Li1433223Kai/stm32-smart-car/README.md

# STM32 智能循迹小车（两层闭环控制）

> **项目状态（2026-10）**：速度环 PI、显式状态机、FreeRTOS 运行时验证（调度器 / 时基 / 电机·编码器·灰度回归 / 多任务时间片轮转）均已实测通过，控制、串口、显示已拆成三个独立 RTOS 任务；位置环循迹参数在标准场地适配中（灰度模块为固定阈值，需白底黑线场地）。实车跑完整赛道待验证。

基于 STM32F103C8T6 独立开发的两轮差速闭环循迹小车。核心是**两层控制闭环**：

- **速度环（内环）**：编码器测速 + PI 控制，让左右轮精确达到目标转速
- **位置环（外环）**：8 路灰度循迹，根据黑线位置动态分配左右目标转速，实现差速转向

运行在 **FreeRTOS V9.0.0** 上：运行时验证（调度器 / 时基 / 外设回归 / 多任务轮转）通过后，控制逻辑先从裸机主循环搬进 `controlTask`（`vTaskDelayUntil` 锁 10ms 周期），随后串口打印与 OLED 显示也各自拆成独立任务。

通过该实践掌握：嵌入式软件分层架构（BSP/App）、PWM 调速、定时器编码器测速、PID 整定、显式状态机、FreeRTOS 任务划分、VOFA+ 上位机调参、实时性与踩坑排查。

## 实测验证（2026-08 ~ 2026-10）

- **速度环已实测调通**：闭环自动补偿两电机死区差异（左轮启动 PWM>600、右轮>400），消除纯 P 控制稳态静差
- **状态机已实测验证**：全黑/全白哨兵值优先判定避免电机失控；按键原地恢复运行
- **串口实时性修复验证**：修复 printf 阻塞拖垮 10ms 控制节拍导致速度环正反馈失控的问题
- **FreeRTOS 运行时验证通过**：调度器启动、时基递增、电机 / 编码器 / 灰度三项外设回归、多任务时间片轮转
- **控制任务重构已验收**：控制逻辑搬入 `controlTask`，功能回归通过；10ms 节拍锁定（100 拍 = 1000 tick，IDLE / RUN 态均无漂移）
- **三任务拆分已验收**：控制 / 串口 / 显示各一个任务；显示 200ms 一帧、实测单帧 133ms，同期控制节拍仍是 100 拍 = 1000 tick
- **OLED 已恢复显示**：驱动改走软件模拟 I2C（PB3/PB4），四行数据面板实测无残留
- **位置环循迹**：参数整定中，需白底黑线标准场地验证

## 硬件演进（实际搭建照片）

| 阶段 | 照片 |
|---|---|
| 8.18 基础版（能跑） | [`project/img/8.18基础可跑版.jpg`](project/img/8.18基础可跑版.jpg) |
| 8.21 加灰度循迹 | [`project/img/8.21带灰度版1.jpg`](project/img/8.21带灰度版1.jpg) · [`project/img/8.21带灰度版2.jpg`](project/img/8.21带灰度版2.jpg) |
| 8.25 加编码器测速 | [`project/img/8.25带编码器1.jpg`](project/img/8.25带编码器1.jpg) · [`project/img/8.25带编码器2.jpg`](project/img/8.25带编码器2.jpg) |
| 8.25 重装固件 | [`project/img/8.25重装后1.jpg`](project/img/8.25重装后1.jpg) · [`project/img/8.25重装后2.jpg`](project/img/8.25重装后2.jpg) |

## 系统架构

```
      位置环(外环)                 速度环(内环)
 灰度 pos ──→ 左右目标速度 ──→ PI ──→ PWM ──→ 电机 ──→ 编码器 ──→ 测速
      ▲                                                 │
      └──────────────────── 反馈 ──────────────────────────┘
```

## 软件分层

| 层 | 文件 | 职责 |
|---|---|---|
| BSP 驱动 | `bsp_motor.c` / `bsp_motor.h` | TB6612 电机 PWM + 方向安全时序 |
| BSP 驱动 | `bsp_gray.c` / `bsp_gray.h` | 8 路灰度读取、加权位置计算 |
| BSP 驱动 | `bsp_encoder.c` / `bsp_encoder.h` | 定时器编码器测速（RPM） |
| BSP 驱动 | `bsp_key.c` / `bsp_key.h` | 非阻塞去抖 + 沿检测按键 |
| BSP 驱动 | `bsp_oled.c` / `bsp_oled.h` | SSD1306 软件模拟 I2C 驱动 |
| BSP 驱动 | `bsp_uart.c` / `bsp_uart.h` | 打印队列 + `uartTask` |
| App 控制 | `app.c` / `app.h` | 位置环 + 速度环 PID、状态机、`controlTask`、`displayTask` |
| RTOS | `FreeRTOSConfig.h` / `freertos_hooks.c` | 内核裁剪与钩子函数 |
| 主程序 | `main.c` | 初始化 + 创建三个任务 + 启动调度器 |

## 技术要点

- 定时器编码器模式（TIM2/TIM4，4 倍频，1040 脉冲/圈，10ms 采样测速）
- 位置环 P + 速度环 PI 串级差速控制，积分 / 目标 / PWM 三重限幅防饱和
- IDLE / RUN / LOST / CROSS 显式状态机（10ms 调度）
- VOFA+ 上位机曲线调参（FireWater CSV）
- FreeRTOS V9.0.0（RVDS/ARM_CM3 port，heap_4）：控制 / 串口 / 显示三个任务，`vTaskDelayUntil` 锁周期，中断向量表已交内核接管
- 硬件细节：TB6612 换向安全时序、CD4051 切换 50us 稳定延时、编码器引脚上拉、OLED 走软件模拟 I2C 绕开已损坏的 PB8/PB9

## 硬件

- 主控：STM32F103C8T6
- 驱动：TB6612 双路（D153C）
- 电机：MG310 直流减速电机（霍尔编码器，13 线，减速比 20）
- 传感器：8 路数字灰度（CD4051 选通 + LM393 比较）
- 供电：12V 锂电池 → DCP3512（12V 电机 / 5V 主控与灰度，分路供电）

## 文档导航

| 文档 | 内容 |
|---|---|
| [project/docs/项目总结.md](project/docs/项目总结.md) | 项目总结 |
| [project/docs/调试记录.md](project/docs/调试记录.md) | 28 条踩坑排查 |
| [project/docs/开发日志.md](project/docs/开发日志.md) | 开发过程 |
| [project/docs/模块说明.md](project/docs/模块说明.md) | 各模块实现说明 |
| [project/docs/硬件连接.md](project/docs/硬件连接.md) | 引脚与供电 |
| [project/docs/项目参数.md](project/docs/项目参数.md) | 控制参数 |
| [project/docs/版本说明.md](project/docs/版本说明.md) | v1.0 ~ v2.2 演进 |

## 进展与规划

**已完成（2026-10）**

- **FreeRTOS V9.0.0 接入 + 运行时验证**：源码导入与向量表接管（09-23）→ 调度器启动与首任务（10-08）→ 时基和电机 / 编码器 / 灰度三项外设回归（10-09）→ 多任务时间片轮转（10-10）
- **控制任务重构**：裸机主循环三行控制逻辑搬入 `controlTask`，功能回归与 10ms 节拍验证均通过
- **串口与显示拆分**：串口改 snprintf + 队列 + `uartTask`，OLED 改 `displayTask` 每 200ms 一帧，控制任务不再被阻塞式打印和刷屏占用。架构现为**控制 / 串口 / 显示三个任务**
- 验证留档：[时基 dt 全为 1000](project/img/10.9时基验证_dt全为1000.png) · [编码器速度符号与正反转](project/img/10.9编码器验证_左右速度符号与正反转.png) · [控制任务功能回归](project/img/10.10控制任务重构_功能回归ST1到ST3.png) · [节拍 100 拍 1000 tick](project/img/10.10控制任务节拍验证_100拍1000tick.png)

**下一步**

- 实车跑完整赛道（当前 RTOS 架构下只做过架空功能回归）
- 标准场地循迹参数适配、量化性能数据（稳态误差 / 超调 / 线速度）

**更远**

- 串口升级为 **DMA + 空闲中断 + 环形缓冲**，支持不定长协议
- ADC 电池电压监测、SPI Flash（W25Q64）驱动
