Li1433223Kai/stm32-smart-car/project/docs/项目总结.md

# STM32 智能循迹小车 —— 项目总结

> 更新：2026-10-16（FreeRTOS 源码接入 2026-09-23，首次运行验证 2026-10-08，时基与三项功能回归验证 2026-10-09，多任务轮转验证 2026-10-10，控制逻辑搬入 controlTask 2026-10-10，串口与显示拆为独立任务 2026-10-15~10-16）
> 定位：独立开发，作为嵌入式软件方向的能力证明
> 代码：`../code/smart/`（Keil MDK 工程，Target: f103）

## 一、项目概述

基于 STM32F103C8T6（Cortex-M3）独立搭建并开发的两轮差速循迹小车，
实现「位置环 P + 速度环 PI」串级双闭环控制。目标不只是拼模块跑起来，
而是用分层架构、显式状态机、实时性意识和闭环控制，把一辆车从零**调通**。

## 二、项目目标与范围

- **主线**：从零搭建一辆「速度环调通、能循迹」的小车，覆盖 驱动 → 控制 → 实时性 → 调试 全链路
- **工程化**：BSP/App 分层、模块化驱动、规范提交、完整技术文档
- **实时性**：10ms 控制节拍稳定，不被 IO 阻塞破坏
- **边界**：不追求花哨功能，把单个方向做到深度可讲

## 三、系统与硬件

| 模块 | 说明 |
|---|---|
| 主控 | STM32F103C8T6 |
| 电机驱动 | TB6612 双路（D153C），PWM 0~7200 |
| 电机 | MG310 直流减速电机（霍尔编码器 13 线，减速比 20） |
| 测速 | TIM2/TIM4 定时器编码器模式，4 倍频，1040 脉冲/圈，10ms 采样 |
| 循迹 | 8 路数字灰度（CD4051 选通 + LM393 比较），加权位置 -7000~+7000 |
| 显示 | SSD1306 0.96" OLED，软件模拟 I2C，SCL=PB3 / SDA=PB4 |
| 按键 | PA8 上拉，非阻塞去抖 + 沿检测 |
| 供电 | 12V 锂电 → DCP3512（12V 电机 / 5V 主控与灰度，分路供电） |

完整引脚见 `硬件连接.md`。

## 四、软件架构

按 BSP（驱动层）/ App（应用层）两层组织，`main.c` 只做初始化、创建任务、启动调度器：

```
BSP 驱动层：bsp_motor / bsp_gray / bsp_encoder / bsp_key / bsp_oled / bsp_uart
App 应用层：app.c（位置环 + 速度环 + 状态机 + controlTask + displayTask）
main.c    ：初始化 + 创建三个任务 + 启动调度器

三个任务的分工：
  controlTask   优先级 2   10ms 一拍    编码器更新 / 状态机 / 速度环
  uartTask      优先级 1   阻塞等队列   取一帧 printf 一帧
  displayTask   优先级 1   200ms 一拍   刷 OLED 数据面板
```

自写代码约 1000+ 行（不含 HAL 驱动库），分 16 个源文件。

## 五、核心实现

### 1. 串级双闭环控制
- **位置环（外环）**：`Gray_GetPosition()` 返回黑线位置 pos（-7000~+7000，哨兵值 9999/-9999），
  P 控制算出左右轮目标转速差，实现差速转向
- **速度环（内环）**：编码器 10ms 采样 → RPM，PI 控制达到目标转速
- **三重视限幅防饱和**：积分限幅 2000、目标限幅（40~200）、PWM 限幅 7200

### 2. 显式状态机（IDLE / RUN / LOST / CROSS，10ms 调度）
- IDLE：上电默认停车，200ms 屏蔽按键防上电误触，按 PA8 进 RUN
- RUN：正常压线跑位置环；全白 → LOST，全黑 → CROSS
- LOST / CROSS：进入当拍 `App_Stop()` 清目标积分 + `Motor_BrakeAll()` 短接刹车，并用 `s_brake` 标志保持刹车态（速度环短路不再输出，避免覆盖）；按 PA8 原地恢复，无需断电重启
- 关键：全白/全黑**先判 ±9999 哨兵值再进位置环**，避免异常值被当作极大偏差驱动电机疯转

### 3. 实时性处理
- **修复 printf 阻塞**：`fputc` 原用 `HAL_MAX_DELAY` 无限等待，串口变慢时把 10ms 节拍拖到
  数百 ms，速度环采样间隔不稳形成正反馈、电机失控反转；改为 50ms 超时 + 打印限频 500ms
- **把耗时 IO 挪出控制任务**：控制任务里的 printf 换成 snprintf + 队列（`Uart_Send` 入队即返回，满则丢帧），
  刷屏从控制任务挪进 `displayTask`，控制任务的当拍时间不再被这两样占着

### 4. 硬件相关细节
- TB6612 换向遵循「关 PWM → 改方向 → 恢复 PWM」，避免绕组电感电流突变产生数倍堵转电流尖峰
- CD4051 通道切换后保留 50us 等 LM393 比较器稳定（缺失时实测通道 1/5 互换误读）
- 编码器引脚改上拉输入，抑制信号线虚接时计数乱跳
- OLED 改走软件模拟 I2C（PB3/PB4）：硬件 I2C1 在这块板上没有落点——默认的 PB6/PB7 被右编码器占了，重映射的 PB8/PB9 已被旧屏那次的 12V 打穿

## 六、关键参数

| 项 | 值 |
|---|---|
| 位置环 | KP=1.5，BASE_SPEED=120 RPM，TARGET_MIN=40，MAX_STEER=80 |
| 速度环 | PID_KP=15，PID_KI=1，INTEGRAL_MAX=2000 |
| PWM | 0~7200 |
| 测速 | 1040 脉冲/圈，10ms 采样 |

## 七、实测验证结果（截至 2026-10）

| 项 | 状态 |
|---|---|
| 速度环闭环 | 调通：自动补偿左右轮死区差异，消除稳态静差 |
| 状态机 | 验证：全黑/全白不失控（8.31 桌面）、LOST 触发与 PA8 原地恢复（9.12 实车） |
| 快速刹车（s_brake 保持） | 实车验证（9.12，甩-松手判据：快甩松手立即停转） |
| Δt 实测间隔测速 | 编译通过，待实车回归对照 |
| 串口实时性 | 修复验证：10ms 节拍恢复，打印不再拖慢 |
| 位置环循迹 | 参数整定中，需白底黑线标准场地（灰度为固定阈值） |
| OLED | 已恢复显示：驱动改走软件模拟 I2C（PB3/PB4），四行数据面板实测无残留 |
| **量化性能数据** | **待测**：稳态误差 / 阶跃超调 / 调节时间 / 循迹线速度 / 直线偏差 |
| **FreeRTOS 工程编译** | 0 Error / 8 Warning（2026-10-08；Code=11908、ZI-data=11840，堆已落地） |
| **FreeRTOS 源码接入（导入 / 分组重组 / Config / 向量表接管）** | 完成（2026-09-23）——**仅并入源码、搭好工程环境，业务逻辑未改** |
| **FreeRTOS 中断向量表接管** | map 文件验证：SVC/PendSV/SysTick 符号落在 port.o（2026-09-23） |
| **FreeRTOS 调度器启动 + 首任务运行** | 实测通过（2026-10-08）：PC13 每 500ms 闪烁 + 串口输出 `control test start`；堆随任务创建落地（ZI 1596→11840） |
| **FreeRTOS 时基验证** | 实测通过（2026-10-09）：连测 18 次 `vTaskDelay(1000)` 的 `HAL_GetTick()` 差值全部为 1000，tick hook 链路导通、无丢拍、无漂移 |
| **FreeRTOS 外设功能回归（电机 / 编码器 / 灰度）** | 实测通过（2026-10-09）：电机正反转+刹车节奏正常；编码器正转读数为正、反转读数为负、左右符号一致、刹车归零（截图 `project/img/10.9编码器验证_左右速度符号与正反转.png`）；灰度 pos 稳定、方向与哨兵值正常。顺带销案"右编码器 A/B 是否也反——未验证"→ 实测未反 |
| **FreeRTOS 多任务轮转** | 实测通过（2026-10-10）：建两个同优先级任务（task1/task2，优先级均 2）各自刷串口，1 与 2 成块交替出现，时间片（1ms）轮转生效 |
| **FreeRTOS 串口早期输出异常（fputc）** | 已修（2026-10-10）：原 fputc 用 HAL_UART_Transmit(...,50)，其超时靠 HAL_GetTick，而 suspend 窗口内 uwTick 冻结导致超时失效、早期丢字；改为不依赖 tick 的寄存器版 |
| **FreeRTOS 运行时验证（四项）** | 全部通过：调度器能跑 / 时基 / 三项外设回归 / 多任务轮转（2026-10-08~10-10） |
| **控制任务重构** | 验收通过（2026-10-10）：裸机主循环三行搬入 `controlTask`，功能回归通过；100 拍 = 1000 tick |
| **串口 / 显示拆分为独立任务** | 验收通过（2026-10-16）：串口走队列 + `uartTask`，显示走 `displayTask`（200ms 一帧、实测单帧 133ms）；同期控制节拍仍是 100 拍 = 1000 tick |
| **OLED 字模** | 换 VGA 8x16 点阵，字形只占第 2~11 行，四行文本之间有了行距 |
| **架构是否已切换为多任务 RTOS** | 已切换——控制 / 串口 / 显示三个任务（串口 10-15、显示 10-16 完成后定稿）；中断与调度由 FreeRTOS 接管 |

> **量化数据待补**：目前有「参数」暂无「性能指标」。计划标准场地循迹调通后，
> 用 VOFA+ 抓波形，测出稳态误差、超调量、调节时间与循迹线速度，回填本节。

## 八、踩坑总结（28 项，详见 调试记录.md）

按类别归纳：

- **接线/接触类（最常见：#4 #7 #10 #11）**：杜邦线内部断、AD0/AD2 接反、编码器 A/B 接反、面包板虚接
  → 学会用「交换测试 / 交叉验证」定位
- **电源类（#5）**：供电反接烧驱动板 → 先量电源轨短路再上电
- **流程类（#19 #20）**：printf 阻塞拖垮控制节拍、改完代码忘了烧录——问题往往不在想查的那一层 → 养成"验收先确认烧录版本、复现最先做"的习惯
- **程序/工程（#2 #3 #8 #15）**：Keil 插件终端、缺 stdio.h、main 少 `}`、VSCode 工程打开方式
- **硬件个体差异（#6）**：电机死区不同 → 闭环 PID 自动补偿
- **控制参数（#12 #13）**：低速量化误差放大 → Kp 50→15；纯 P 静差 → 加 Ki
- **实时性（#19）**：printf 阻塞破坏节拍 → 超时 + 限频；后来进一步拆成独立任务
- **外设时序（#7）**：CD4051 切换 50us 稳定延时
- **显示（#28）**：新屏不亮，一步步剥下来是 PB8/PB9 的引脚保护结构被旧屏 12V 打穿（推挽顶高只有 0.6V、二极管档双向导通），OLED 因此改走软件模拟 I2C 到 PB3/PB4
- **RTOS 时序/环境类（#23~#27）**：**#23** HAL 与 FreeRTOS 抢用 SysTick —— HAL 在 `HAL_Init` 里就提前使能了 SysTick，而向量表已交给 FreeRTOS、调度器却还没启动，第一次 tick 进来即解引用未初始化的延时链表 → HardFault（LED 常亮）。编译、链接、向量、配置全对，**静态检查抓不到**，只能靠"谁在什么时候第一次碰内核状态"的时序链推 → 修复要"关两次"（`HAL_Init` 后 + `SystemClock_Config` 后各 `HAL_SuspendTick()`）；**#24** 修完后验证时基未因 tick 链路多绕两道而失准（连测 18 次 `dt` 全为 1000）；**#25** 三项外设回归（电机/编码器/灰度）—— 采样型任务（编码器、灰度）必须用 `vTaskDelayUntil` 锁周期而非 `vTaskDelay`，且打印必须降频（一行约 10 字符约 10ms，不降频会吃满 10ms 采样周期）；**#26** 多任务轮转验收（两个同优先级任务各自刷串口、1 与 2 成块交替），排查过程中还发现"注释掉两个任务后早期日志就正常"——早期 printf 其实一直有发出去，只是被无间隔刷屏抢了接收时序；**#27** 动了 HAL 时基（`HAL_SuspendTick`）之后，所有靠 `HAL_GetTick()` 做超时的 HAL 函数都会失效，范围不止 `HAL_Delay` 型延时，UART/I2C 收发与各 `HAL_xxx_Init` 全在内，表现为静默丢字/乱码，不报错也不 HardFault —— 修法是把 `fputc` 改成不依赖 tick 的纯寄存器版

## 九、技术收获

1. 分层架构与模块化：单一职责、接口封装（BSP/App）
2. 串级控制整定的真实手感：内环带宽、量化误差、积分限幅
3. 显式状态机的边界处理：哨兵值、进入沿检测
4. 嵌入式实时性意识：阻塞 IO 对控制节拍的破坏与规避
5. 硬件调试方法论：交叉验证、分级上电、先量短路
6. 版本管理与文档习惯：Conventional Commits、6+ 份文档、记录踩坑

## 十、不足与后续规划

| 项 | 现状 | 规划 |
|---|---|---|
| 串口 | 队列 + `uartTask` | **DMA + 空闲中断 + 环形缓冲**（不定长协议） |
| 控制节拍 | `vTaskDelayUntil` 锁 10ms | **独立定时器节拍**（不依赖 SysTick） |
| 外设 | 已有 7 个驱动 | **ADC 电池监测、SPI Flash(W25Q64)** |
| 架构 | 控制 / 串口 / 显示三个任务 | 实车跑通后按需再拆，补齐任务间通信 |
| 循迹验证 | 待标准场地 | 白底黑线场地完整跑通 |
| 性能数据 | 待测 | 稳态误差 / 超调 / 线速度等量化指标 |
| 硬件 | 模块 + 杜邦线 | 自研扩展板 PCB（嘉立创 EDA） |

## 十一、一句话总结

一辆把「分层架构、串级双闭环、显式状态机、实时性、硬件调试」全部落到真实硬件上的
STM32 循迹小车；**速度环、状态机与快速刹车验证通过，FreeRTOS 接入后已把控制 / 串口 / 显示拆成三个任务并实测节拍不受影响（控制 100 拍 = 1000 tick），位置环循迹与性能数据在标准场地继续完善**。
