Li1433223Kai/stm32-smart-car/project/img/8.21带灰度版1.jpg

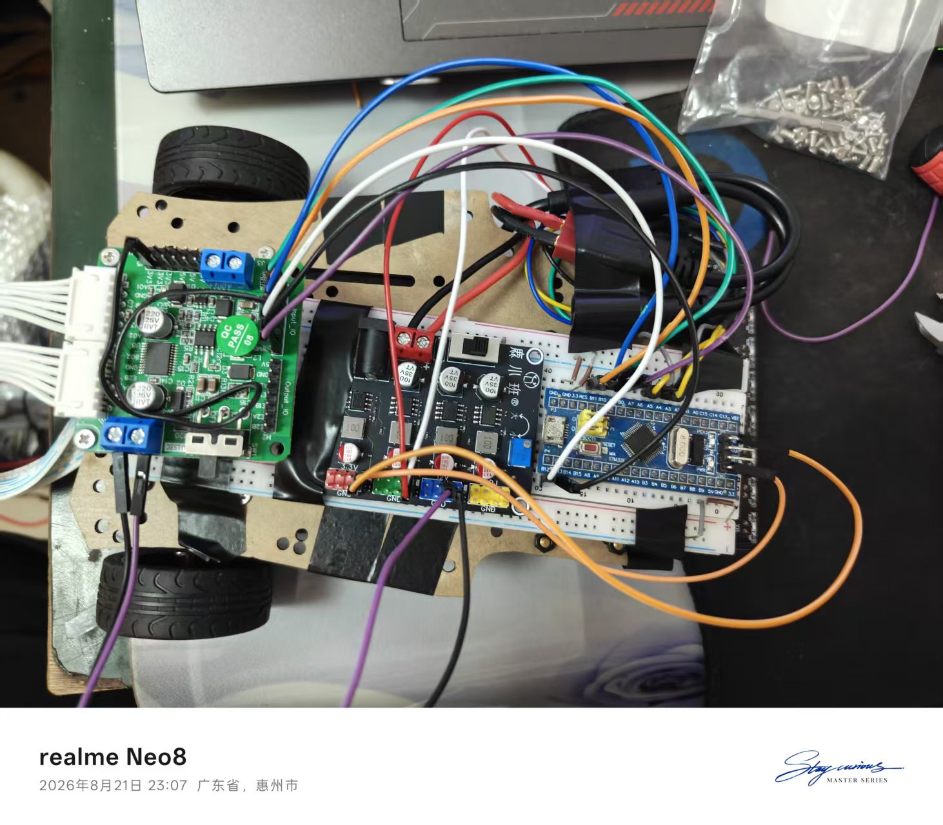
project/img/8.21带灰度版1.jpg
