Li1433223Kai/stm32-smart-car/project/img/8.25重装后1.jpg

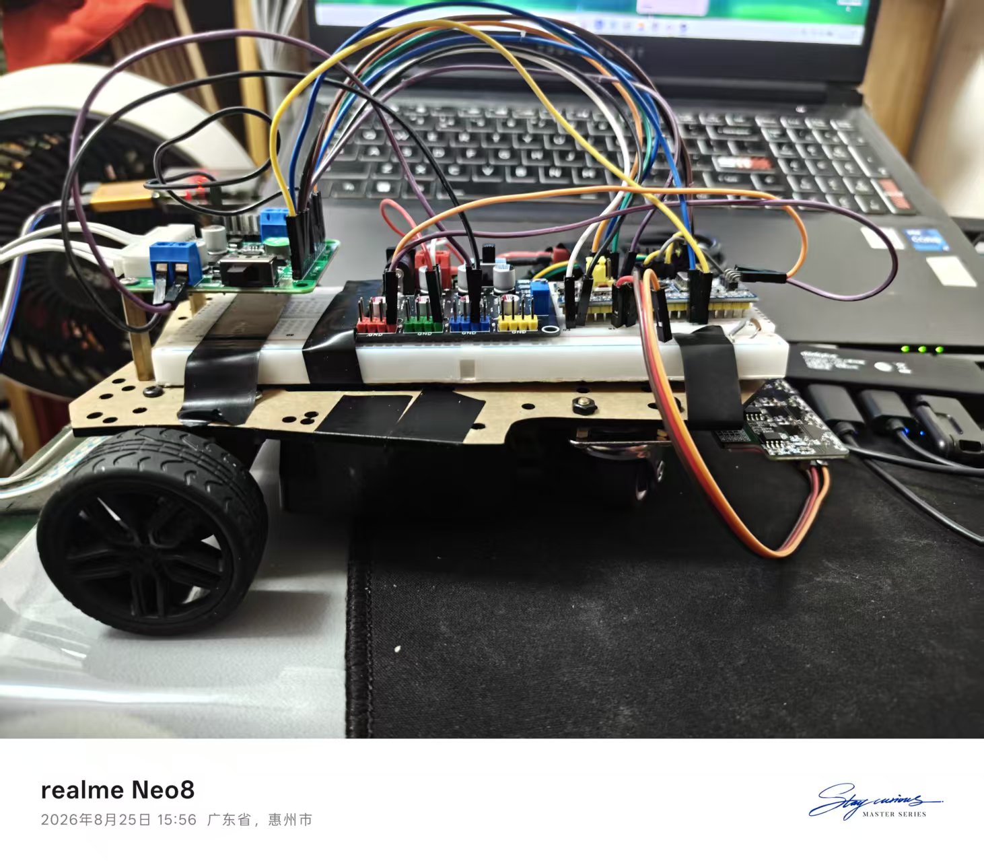
project/img/8.25重装后1.jpg
