Li1433223Kai/stm32-smart-car/project/code/smart/Core/Src/main.c

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
/* Includes ------------------------------------------------------------------*/
#include "main.h"
#include "tim.h"
#include "usart.h"
#include "gpio.h"

/* USER CODE BEGIN Includes */
#include <stdio.h>
#include "bsp_motor.h"
#include "bsp_gray.h"
#include "app.h"
#include "bsp_encoder.h"
#include "bsp_oled.h"
#include "bsp_key.h"
#include "FreeRTOS.h"
#include "task.h"
#include "bsp_uart.h"
/* USER CODE END Includes */


void SystemClock_Config(void);
/**
  * @brief  The application entry point.
  * @retval int
  */
int main(void)
{

  /* MCU Configuration--------------------------------------------------------*/

  /* Reset of all peripherals, Initializes the Flash interface and the Systick. */
  HAL_Init();
  

  /* USER CODE BEGIN Init */
  HAL_SuspendTick();
  /* USER CODE END Init */

  /* Configure the system clock */
  SystemClock_Config();
  HAL_SuspendTick(); //成对存在


  /* Initialize all configured peripherals */
  MX_GPIO_Init();
  MX_USART1_UART_Init();
  MX_TIM3_Init();
  MX_TIM2_Init();
  MX_TIM4_Init();
  /* I2C1 外设已弃用: OLED 改走 PB3/PB4 软件 I2C, 见 BSP/bsp_oled.c */
  /* USER CODE BEGIN 2 */
  Motor_Init();
  Motor_StopAll();     /* 开始循迹前电机先停 */
  Gray_Init();
  App_Init();
  Encoder_Init();
  Key_Init();
  Uart_Init();

  /* 控制任务栈 256 word(1KB): 调用链里有 snprintf, 128 word(512B) 余量偏紧 */
  if(xTaskCreate(controlTask,"controlTask",256,NULL,2,NULL) != pdPASS)
  {
	printf("controlTask fail\r\n" );
	Error_Handler();		  
  }
  
  if(xTaskCreate(uartTask,"uartTask",192,NULL,1,NULL) != pdPASS)
  {
	printf("uart fail\r\n" );
	Error_Handler();		  
  }
  
  if(xTaskCreate(displayTask,"displayTask",192,NULL,1,NULL) != pdPASS)
  {
	printf("display fail\r\n" );
	Error_Handler();		  
  }
  vTaskStartScheduler();
  /* USER CODE END 2 */

  /* Infinite loop */
  
  /* USER CODE BEGIN WHILE */
  while (1)
  {
    /* USER CODE END WHILE */

    /* USER CODE BEGIN 3 */

  }
  /* USER CODE END 3 */
}
  

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
/* USER CODE BEGIN 4 */
int fputc(int ch, FILE *f)
{
    /* 直接写寄存器, 纯空转等 TXE, 不依赖 HAL_GetTick 超时 */
    uint32_t guard = 0;
    while (!(USART1->SR & USART_SR_TXE) && ++guard < 100000)
    {
    }
    USART1->DR = (uint8_t)ch;
    return ch;
}
/* USER CODE END 4 */
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
