Li1433223Kai/stm32-smart-car/project/code/smart/Core/Inc/main.h

#define LED_Pin GPIO_PIN_13
#define LED_GPIO_Port GPIOC
#define AIN1_Pin GPIO_PIN_10
#define AIN1_GPIO_Port GPIOB
#define AIN2_Pin GPIO_PIN_11
#define AIN2_GPIO_Port GPIOB
#define BIN1_Pin GPIO_PIN_12
#define BIN1_GPIO_Port GPIOB
#define BIN2_Pin GPIO_PIN_13
#define BIN2_GPIO_Port GPIOB
#define GRAY_AD0_Pin GPIO_PIN_2
#define GRAY_AD0_GPIO_Port GPIOA
#define GRAY_AD1_Pin GPIO_PIN_3
#define GRAY_AD1_GPIO_Port GPIOA
#define GRAY_AD2_Pin GPIO_PIN_4
#define GRAY_AD2_GPIO_Port GPIOA
#define GRAY_OUT_Pin GPIO_PIN_5
#define GRAY_OUT_GPIO_Port GPIOA
