Li1433223Kai/stm32-smart-car/(commit log)

2026-08-20 feat: 智能循迹车项目初始提交
    - 基于STM32F103C8T6 + HAL库 + Keil MDK工程框架
    - 实现TB6612双路电机驱动(D153C), TIM3 CH3/CH4输出10kHz PWM
    - 电机方向控制: PB10/PB11(左), PB12/PB13(右)
    - 串口USART1调试输出(PA9/PA10), printf重定向
    - LED闪烁 + 电机正反转2秒循环测试程序
    - BSP层封装: Motor_Init/Motor_SetSpeed/Motor_Stop/Motor_Brake/Motor_StopAll
    - MotorID枚举适配D153C双路板: MOTOR_A(左轮)/MOTOR_B(右轮)
    - 修复Motor_Brake中PWM=0导致高阻态而非真刹车的bug
    - 添加项目文档: 硬件连接、开发日志、调试记录、模块说明等
    - 包含STM32F1xx HAL库和标准外设库旧模板
2026-08-21 feat: 适配D153C双路TB6612驱动板，修复方向切换时序
    - 引脚标签重命名: BIN1/BIN2→AIN1/AIN2(左轮), CIN1/CIN2→BIN1/BIN2(右轮)
    - 更新main.h/gpio.c/bsp_motor.c/bsp_motor.h/f103.ioc中所有引用
    - 修复Motor_SetSpeed方向切换顺序: 先关PWM(CCR=0)→切方向引脚→开PWM
    - 修复Motor_Brake顺序: 先设IN1=IN2=1→再设PWM满占空比
    - Motor_Init安全启动: 方向引脚先清零→CCR=0→启动PWM
    - 更新tim.c PWM通道注释: PB0=PWMB(右), PB1=PWMA(左)
2026-10-13 docs: 添加8.21调试记录(电机死区/驱动板适配/方向切换时序)
    补上 8.21 的调试记录，三条：
    - 低 PWM 下左轮不动、右轮正常，定到电机个体死区差异（左轮 >600 才转、右轮 >400）
    - 换 D153C 驱动板后转向乱，是代码里的引脚标签没跟着改成 AIN1/AIN2、BIN1/BIN2
    - 方向切换时电机抖一下，是切换顺序不安全，改成先关 PWM 再切方向
    main.c 的测试 PWM 从 3000 降到 1500，先避开死区。
2026-10-13 feat: 添加八路数字灰度传感器驱动(bsp_gray)
    - 引脚分配: PA2=AD0, PA3=AD1, PA4=AD2(通道选择), PA5=OUT(数字输入)
    - 在f103.ioc/main.h/gpio.c中配置GPIO
    - 实现Gray_Init/Gray_ReadChannel/Gray_ReadAll/Gray_GetPosition
    - 加权位置算法: -7000~+7000表示黑线偏离中心位置
    - 支持丢线(9999)和全黑(-9999)状态检测
    - main.c测试程序: 串口每100ms打印8路灰度值和位置
2026-10-13 fix: 修正灰度传感器驱动(根据官方手册)
    - 供电电压: 5V(不是3.3V!)
    - 输出电平: 黑线=1(灯亮=高电平), 白线=0(灯灭=低电平), 与官方例程一致
    - 通道切换延时: 从NOP改为50us延时(匹配官方例程delay_us(50))
    - 添加Gray_Delay_us微秒延时函数
    - 更新注释: 通道CH1~CH8对应数组索引0~7, 最佳高度18mm
2026-10-13 fix: 修正main.c灰度测试注释(1=黑0=白)
    main.c 里灰度输出的注释写反了。按实际约定改回 1=黑（灯亮）、0=白（灯灭），
    跟 bsp_gray 内部判读对齐，免得之后照注释把方向调反。
2026-10-13 fix: 恢复灰度通道切换50us延时，修复通道1/5互换
    灰度测试发现通道1与5数据互换，根因是读取OUT前缺少50us稳定延时(LM393比较器未稳定即采样)；另修正AD0/AD2接线。灰度8路现已全部验证正常。
2026-10-13 docs: 补全8.23灰度通道错位调试记录(原因与解决方法)
    8.23 灰度错位那条当时只记了现象（挡 1 号灯亮 5 号、打印成 51372648），
    这次补上原因和解法：AD0/AD2 接反，加上通道切换后没留稳定延时，两个问题
    叠一起才出的乱码。
2026-10-13 chore: 删除旧标准库模板工程(2-1stm32工程模板)
    删掉已经不用的标准库模板工程（2-1stm32工程模板，带一整份 StdPeriph 库，
    几百个文件），工程只留 HAL 这套。
2026-10-13 docs: 添加代码逻辑目录文档(开发日志/motor逻辑等)
    搭 docs 的架子：新增 motor.md 写电机驱动逻辑，模块说明、硬件连接、项目参数、
    项目总结先建空文件占位，开发日志补个开头。内容后面逐步填。
2026-10-13 feat: 添加循迹控制模块框架(app.c/app.h)
    建应用层骨架。app.c/app.h 放循迹逻辑，由 main 主循环按固定节拍调用，
    里面只调 bsp_motor 和 bsp_gray 的接口，不碰寄存器。
    这一版只做"纯直行"：读一下 pos 但先不用，两轮给同一个 base 速度。为的是
    确认两个电机都能正转、base 选得住（得高于左轮死区）。差速留到下一步。
2026-10-13 feat: 将app.c加入Keil工程，并忽略Keil本地配置uvoptx
    把 app.c 加进 Keil 工程的 BSP 分组，编译时能带上。同时把 f103.uvoptx
    从版本控制里去掉：这是 Keil 的本地窗口/断点配置，只对本机有效，入库没意义。
2026-10-13 feat: 接入app循迹主循环，更新灰度引脚配置并记录8.24调试
    main 主循环从原来的"只打印灰度"改成调 App_Follow()：20ms 跑一拍循迹，
    另外每 200ms 打一次 pos 方便看。灰度引脚配置跟着 CubeMX 重新生成一起更新。
    调试踩的坑记进文档：改主循环时 main() 少写了个右括号，后面的函数全被
    包进 main 里，报 function definition is not allowed here。
2026-10-13 feat: 实现循迹差速逻辑(P控制+限幅)，更新调试记录
    灰度能给出位置偏差 pos 了，接上第一版循迹。先用最简单的比例控制，把
    "读到偏差 -> 两轮差速"跑通，逻辑对不对先放一边，参数后面再调。
    - 转向量 steer = Kp * pos（Kp=1）。左轮 = base + steer，右轮 = base - steer，
    线偏右就左轮快，把车头拉回线上
    - 单轮限幅 [600, 7200]，防止一侧被拉停或者超载
    - 全黑走直行、全白停车，这两个哨兵值单独走分支，不套差速
    - base 从 2000 降到 1500，先给转向留点余量
2026-10-13 feat: 新建编码器模块框架(bsp_encoder.c/h占位)
    给编码器模块先占个位，把 BSP 的目录结构铺好，具体实现下一步再写。
2026-10-13 feat: 添加编码器测速和速度环PID控制(编码器配置+PI调速)
    位置环要想往外给目标，得先有个能跟住目标的执行机构，所以先把速度环（内环）立起来。
    - 编码器：TIM2 接左轮、TIM4 接右轮（编码器模式）。Encoder_Init 开计数，
    Encoder_UpdateSpeed 每 10ms 取一次脉冲数（读完清零），按 20 线 x 13 减速比
    x 4 倍频 = 1040 脉冲/圈 换成 RPM
    - 速度环：PI，每 10ms 调一次，PWM = Kp*err + Ki*积分。积分限幅 2000、
    PWM 限幅 7200，左右轮各自去追 TARGET_SPEED = 150 RPM
    - 参数先给 Kp=50 / Ki=1 起步，后面按实测再调
    验证：串口打左右轮 RPM，正反转符号和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
2026-10-13 docs: 记录编码器与速度环调试过程及重装照片
    补两条记录：8.25 编码器 A/B 接反导致计数是负的；8.27 速度环 Kp=50 一变速
    就震荡、纯 P 有静差。顺带把重装之后的照片存进 img 归档。
2026-10-13 feat: 串口输出改为VOFA+ FireWater CSV格式并提高刷新频率
    想用 VOFA+ 的 FireWater 看左右轮速曲线来调速度环，先把串口输出格式弄对。
    - 改成一串纯 CSV："%d,%d\n"（左轮 RPM, 右轮 RPM）。FireWater 要的是逗号分隔、
    不带通道名，带上标签它只当做一个通道（8.27 记录里有这条）
    - 刷新频率提上去，方便实时看波形
2026-10-13 feat: 实现位置环循迹(差速转向)，整定速度环PI参数
    把"位置环直接给 PWM"改成"位置环给目标轮速"，App_Follow 顺势更名
    App_Position_Control，输出交给速度环去执行。位置环 + 速度环到这里才合上。
    - 位置环：steer = Kp * (pos/7000) * MAX_STEER（Kp=1、MAX_STEER=50、base=150）。
    先把 pos 归一化再加权，输出是目标轮速 target_left/right
    - 目标轮速限幅 [100, 200]，不让转向量把一侧压到 0 或顶到上限
    - 速度环 Kp 从 50 降到 15：变速/低速时编码器脉冲少，量化误差被放大，Kp 大了
    就开始震荡（8.27 记录第 12 条）。Ki 调到 1 把静差压掉
    - 全黑/全白的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
2026-10-13 docs: 整理项目文档，删除冗余文档
    把文档整体捋了一遍：
    - docs 里的文件从 代码逻辑/ 子目录挪到 docs 根
    - 调试记录重写了一遍
    - 模块说明、硬件连接、项目参数从空占位填成正文
2026-10-13 docs: 添加版本说明(v1.0)，更新开发日志(双环闭环+文档整理)
    新增版本说明.md，把 v1.0 到当前的改动列一遍。开发日志补上位置环 + 速度环
    这一段。
2026-10-13 feat: 加入0.96寸OLED显示(硬件I2C1重映射PB8/PB9)
    - 新增bsp_oled.c/.h: SSD1306 ASCII驱动, 基于HAL_I2C_Mem_Write, 8x16字模
    - CubeMX配置I2C1重映射到PB8(SCL)/PB9(SDA), 生成i2c.c/i2c.h并启用HAL_I2C
    - app.c增加App_OLED_Show()刷新数据面板(状态/目标/实测速度/pos偏差)
    - main.c集成OLED_Init + 每100ms刷新
    - 同步 README/开发日志/模块说明/版本说明/调试记录
2026-10-13 docs: 补全OLED模块的硬件连接/模块说明/项目参数文档
    - 硬件连接: 新增OLED接线(SCL=PB8, SDA=PB9, VCC=3.3V)及烧片提醒
    - 模块说明: 新增bsp_oled.c/h模块小节(函数接口/坐标/字号)
    - 项目参数: 新增OLED小节(刷新周期/坐标范围/显示内容)
2026-10-13 feat: 状态机重构 + 按键启停 + 编码器上拉 + 刹车策略
    - 状态机: app.c 新增 AppState_t 枚举(IDLE/RUN/LOST/CROSS)和
    App_State_Update() 每10ms调度, 替换原 if-else 散逻辑
    - 按键: 新增 bsp_key.c/h (PA8 上拉, 50ms 去抖 + 沿检测),
    加入 Keil 工程; IDLE 按 PA8 启动, 上电 200ms 内忽略按键防误触
    - 丢线恢复: LOST/CROSS 按 PA8 可回 RUN 重新起步, 不用断电重启
    - 刹车: 新增 Motor_BrakeAll(); LOST/CROSS 刚进入快速刹车一次
    - 编码器: PA0/PA1/PB6/PB7 改 GPIO_PULLUP 上拉, 信号虚接计数不乱跳
    (tim.c + f103.ioc 同步)
    - 引脚宏: main.h 增加 key_Pin/key_GPIO_Port; gpio.c 配置 PA8 上拉输入
    - 工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
2026-10-13 docs: 完善文档(按键/状态机/参数), 修正调试记录
    - 硬件连接: 新增按键 PA8 小节 + 完整引脚总表
    - 模块说明: 新增按键模块(去抖+沿检测)和状态机小节(转移图+关键坑)
    - 项目参数: 补按键(KEY_WAIT_MS=50/上电防抖200ms)和状态机参数
    - 版本说明: 补 v1.2(按键)/v1.3(状态机)/v1.4(小改进)
    - 开发日志: 补 9.1 条目(上拉/刹车/按键恢复)
    - 调试记录: 补 8.31 三条(全黑疯转/上电误触/串口阻塞)
2026-10-13 tune: 调整位置环循迹参数(KP1.5/BASE120/MAX_STEER80)
    - KP 1->1.5: 弯道响应更果断, 60cm半圆需要差速38RPM时偏出量减半
    - MAX_STEER 50->80: 加大差速上限, 配合 TARGET_MIN 降为40 避免限幅截断转向
    - BASE_SPEED 150->120: 降速换取转向余量, 改善弯道冲出线问题
    - 初始目标速度 150->100: 与 BASE_SPEED 匹配
    - 速度环保持 Kp=15/Ki=1 不动, 避免一次调太多变量
2026-10-13 docs: 更新调试记录/开发日志/版本说明/硬件连接
    - 调试记录/开发日志/版本说明/硬件连接: 按自查意见润色, 改为口语化表述
2026-10-13 docs: 同步位置环参数与 app.c 实际值(KP1.5/BASE120/MIN40/STEER80)
    文档里的位置环参数还是旧值，和 app.c 里对不上。同步成实际的：
    KP=1.5、BASE=120、MIN=40、STEER=80。
2026-10-13 docs: 重写README+新增项目总结+同步PID参数
    README 重写（原来太模板），新增项目总结.md，把硬件、架构、参数、验证过程
    归到一份里。顺带把项目总结上次误提交的空文件补全。
2026-10-13 fix: 刹车机制重做+编码器Δt测速+显示快照每拍更新
    - 刹车: s_brake保持标志+转移当拍执行, 速度环短路防覆盖(实车验收通过)
    - 测速: Encoder_UpdateSpeed改用实测采样间隔Δt, 拆除固定10ms周期假设
    - 显示: 快照每拍更新, 丢线后串口/OLED可见9999/-9999哨兵值
    - pos由状态机传入位置环, 每拍少读一次灰度
    - main.c: OLED初始化/刷新暂注释(旧屏损坏), CONTROL_TICK_MS独立定义
    - bsp_motor: 更正TB6612真值表注释(IN1=IN2=1无论PWM均短接刹车)
2026-10-13 docs: 同步实车验收结果与踩坑记录
    - 调试记录: 新增#20旧固件乌龙/#21 TB6612注释纠错/#22 Δt测速改造
    - 开发日志: 补9.2~9.10(PCB学习)与9.11/9.12条目
    - 版本说明: 新增v1.5
    - 项目总结: 刹车机制描述修正, 验证表补刹车/Δt行, 踩坑22项
2026-10-13 chore: 移入 FreeRTOS 源码并重组 Keil 工程分组
    把 FreeRTOS V9.0.0 源码搬进工程（方案A：直接内嵌，不引外部路径），Keil 加
    BSP/FreeRTOS 分组和对应的 IncludePath，补上 FreeRTOSConfig.h。工程能编过，
    但 Handler 冲突还在，留到下一步。
2026-10-13 fix: 修复 FreeRTOS 中断向量表未接管问题，并补全 Config 缺失项
    ## 问题（原状态编译通过但运行必挂）
    stm32f1xx_it.c 中 SVC_Handler / PendSV_Handler / SysTick_Handler 为强定义，
    链接器选用其 2 字节空壳实现，导致：
    - SVC_Handler 空 -> 第一个任务无法启动
    - PendSV_Handler 空 -> 任务切换失效
    - SysTick_Handler 仅 HAL_IncTick -> FreeRTOS tick 失效
    ## 根因（两层，第二层更隐蔽）
    1. stm32f1xx_it.c 中的强符号覆盖了启动文件的 [WEAK] 定义
    2. 本工程 FreeRTOS 版本为 V9.0.0，port.c 定义的函数名为带前缀的
    vPortSVCHandler / xPortPendSVHandler / xPortSysTickHandler，
    并未 alias 到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
2026-10-13 docs: 同步 FreeRTOS 接入进展与 OLED 硬件情况
    - 项目总结.md: 日期更新至 2026-09-23, 补充 FreeRTOS 状态条目
    (编译 0 Error/7 Warning、中断向量表接管已用 map 验证、运行时待验证),
    架构栏更新为 V9.0.0 已并入
    - 版本说明.md: v1.1 条目补充 OLED 屏幕已损坏
2026-10-13 feat: FreeRTOS 首次运行测试与三项外设功能回归
    首次运行测试（10-08）：
    - main.c 在 HAL_Init 后与 SystemClock_Config 后各补一次 HAL_SuspendTick()
    （成对存在）。SysTick 被 HAL 提前使能而向量表已交给 FreeRTOS、调度器未启动，
    首次 tick 会解引用未初始化的延时链表导致 HardFault；两次 Suspend 让 SysTick
    安静到 vTaskStartScheduler 再由内核自己打开（HAL_RCC_ClockConfig 末尾会重新
    打开 SysTick，故必须两次）
    - app.c/app.h 新增 flipLED 测试任务（翻转 PC13 + vTaskDelay）
    - FreeRTOSConfig.h 堆 17KB -> 10KB（F103C8T6 仅 20KB SRAM）
    三项外设功能回归（10-09）：
    - app.c/ap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
2026-10-13 docs: 记录时基与三项外设回归验证
    - 调试记录新增第 24 条（时基验证：18 次 dt 全为 1000）、第 25 条
    （电机/编码器/灰度三项回归），按原有四段式格式，并内嵌两张实测截图
    - 新增截图：img/10.9时基验证_dt全为1000.png、
    img/10.9编码器验证_左右速度符号与正反转.png（按"日期+测试内容"命名）
    - 项目总结：条数 24 -> 25；新增"时基验证"与"外设功能回归"两行状态；
    架构行与末尾总结同步；第八节 RTOS 类补 #25
    - README：条数 24 -> 25；FreeRTOS 行补外设回归与截图路径
    - 开发日志：10.9 条目补三项外设回归
    - 未验证清单三项转已验证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
2026-10-13 docs: 同步 v1.6 版本说明，统一文档表述
    把 FreeRTOS 移植这一段（v1.6）写进版本说明，同步最新提交和工作区状态。
2026-10-13 feat: 多任务轮转验证通过 + fputc 超时失效修复
    代码：
    - main.c: fputc 改为纯寄存器版（等 TXE 写 DR），不依赖 HAL_GetTick，
    避开 HAL_SuspendTick 窗口内 uwTick 冻结导致的超时失效；删掉临时测试打印
    - app.c/app.h: 新增 task1/task2，同优先级 2，各自刷串口
    验证：两个任务打印 1/2 成块交替，时间片（1ms）轮转生效，
    FreeRTOS 运行时验证四项（调度器/时基/三项外设回归/多任务轮转）全部通过
    文档：调试记录新增 #26（轮转验收）、#27（fputc 根因与修复）；
    项目总结/README/开发日志 同步更新
2026-10-13 docs: 留存测试代码快照并摘除测试任务，准备控制任务重构
    动手改架构前先留个底。把 FreeRTOS 运行时验证阶段的代码整份复制到
    project/code/移植freeRTOS源码后的测试代码/ 存档，去掉编译产物，只留源码和
    Keil 工程。主工程这边把 app.c 里的几个测试任务删掉、清掉 main 里多余的声明，
    准备写 controlTask。
2026-10-13 feat: 裸机主循环重构为 controlTask（功能回归 + 节拍验证通过）
    - 新增 controlTask（BSP/app.c），vTaskDelayUntil 锁 10ms 周期，
    last_wake 在 for 外取基准；搬入 Encoder_UpdateSpeed /
    App_State_Update / APP_Speed_Control 三行，栈 128 word、优先级 2
    - app.h 增加 controlTask 声明
    - main.c 创建 controlTask 并恢复 vTaskStartScheduler()；
    清掉排在调度器之后的死代码主循环及 CONTROL_TICK_MS /
    last_speed_time / last_oled_time / OLED_REFRESH_MS 四个无用变量
    - 编译全量 rebuild 0 Error / 5 Warning（均为既有行尾换行提示），
    Code 9528 -> 11620，ZI-data 1596 -> 11840
    - 功能回归（架空）通过：IDL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
2026-10-13 docs: 同步调试记录与开发日志 + 控制任务验证截图
    - 调试记录.md：新增第 28 条（控制任务重构验收、节拍验证、
    自洽性检验的方法边界、死代码清理）
    - 开发日志.md：10.10 条目追加控制任务重构段
    - project/img/：新增两张验证截图（功能回归 ST1->ST3、
    节拍验证 100 拍 1000 tick）
2026-10-13 docs: 修正调试记录与开发日志表述
    调试记录和开发日志的说法重新捋了一遍，主要是 26 条（多任务轮转验证）：
    之前一直纠结"这算故障还是验收"，改成承认过程中两个异常都真实存在、各有各的
    原因——只刷 2 是 fputc 超时失效，start 打不出来是无节流刷屏把早期输出淹了。
    顺手修了开头漏字、括号没闭合几处笔误。
2026-10-14 docs: README 提到仓库根目录并更新项目状态
    - README.md 从 project/ 移到仓库根，内部路径补上 project/ 前缀
    - 项目状态更新到 2026-10，补 FreeRTOS 运行时验证与控制任务重构进展
    - 项目总结.md 清理一处冗余的提交号引用
2026-10-17 feat: 串口打印并入 FreeRTOS 任务（队列 + uartTask）
    控制任务里每 500ms 一次 printf，要空等 TXE，一条约 2.6ms 全算在当拍里。
    改成 snprintf 拼好一帧入队就返回，由 uartTask 取出来打印。
    - 新增 BSP/bsp_uart.c/.h：Uart_Init 建 4×64 字节队列，Uart_Send 满则丢帧，
    uartTask 用 xQueueReceive 阻塞消费
    - app.c：App_State_Update 里的 printf 换成 snprintf + Uart_Send
    - main.c：建 uartTask（优先级 1，192 word）；控制任务栈 128 → 256 word
    - f103.uvprojx：加入 bsp_uart.c 和 BSP_INC 头文件分组
2026-10-17 feat: OLED 改软件 I2C 并拆出显示任务
    PB8/PB9 被旧屏那次的 12V 打穿（推挽顶高只有 0.6V），这块板上硬件 I2C
    也没有别的落点，改走 PB3/PB4 软件模拟 I2C。显示从控制任务里拆出来，
    单建 displayTask 每 200ms 刷一帧。
    - bsp_oled.c：手写起始/停止/写字节时序，第 9 个时钟切输入上拉读应答；
    新增 OLED_ShowLine，整行拼成上下两页各 128 字节再各写一次，
    整行覆盖所以不再每帧 OLED_Clear
    - 字模换 VGA 8x16 点阵，字形只占第 2~11 行，四行之间有了行距
    - main.c：去掉 MX_I2C1_Init，建 displayTask（优先级 1，192 word）
    - 实测单帧 133ms，占 200ms 周期的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
