Li1433223Kai/stm32-smart-car/(notices)

Notices in the files:
project/code/smart/Core/Inc/main.h:
Copyright (c) 2026 STMicroelectronics.
All rights reserved.
This software is licensed under terms that can be found in the LICENSE file
